shreyD2408/Custom_Esp32_Devboard/BOM.md

# ESP32 Custom DevBoard – bill of materials

<!-- Generated by Half Life from project cmuuqpnhf09n301smdetldqip. Edits here are overwritten on the next sync. -->
<!-- Generated: 2026-10-11T19:33:44.635Z -->

> [!NOTE]
> This parts list is mirrored from [Half Life](https://halflife.hackclub.com). Editing it here will not change the platform's copy, and the next sync overwrites this file.

| Week | Tier | Parts funding |
| --- | --- | --- |
| Week 1 | Tier 2 | $65.00 |

| Part | What it's for | Qty | Unit | Total | Vendor |
| --- | --- | --- | --- | --- | --- |
| [Panasonic Push Button](https://www.lcsc.com/product-detail/C528967.html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) | For user input buttons, and BOOT/RESET buttons | 5 | $0.38 | $1.90 | [LCSC](https://www.lcsc.com/product-detail/C528967.html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) |
| [Ceramic 1uf Capacitors](https://www.lcsc.com/product-detail/C76930.html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) | Passive/Capacitors | 50 | $0.01 | $0.50 | [LCSC](https://www.lcsc.com/product-detail/C76930.html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) |
| [Ceramic 2.2uf Capacitors](https://www.lcsc.com/product-detail/C170151.html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) | Passive/Capacitors | 20 | $0.02 | $0.40 | [LCSC](https://www.lcsc.com/product-detail/C170151.html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) |
| [Ceramic 10uf Capacitors](https://www.lcsc.com/product-detail/C19702.html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) | Passive/Capacitors | 20 | $0.03 | $0.60 | [LCSC](https://www.lcsc.com/product-detail/C19702.html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) |
| [Ceramic 100nf Capacitors](https://www.lcsc.com/product-detail/C14663.html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) | Passive/Capacitors | 50 | $0.01 | $0.50 | [LCSC](https://www.lcsc.com/product-detail/C14663.html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) |
| [Ceramic 10nf Capacitors](https://www.lcsc.com/product-detail/C100042.html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) | Passive/Capacitors | 50 | $0.01 | $0.50 | [LCSC](https://www.lcsc.com/product-detail/C100042.html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) |
| [Ceramic 220nf Capacitors](https://www.lcsc.com/product-detail/C42416726.html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) | Passive/Capacitors | 2 | $0.33 | $0.66 | [LCSC](https://www.lcsc.com/product-detail/C42416726.html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) |
| [USB-C Connector](https://www.lcsc.com/product-detail/C2765186.html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) | Programming and Power Input | 20 | $0.08 | $1.60 | [LCSC](https://www.lcsc.com/product-detail/C2765186.html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) |
| [ESD Protection Diodes](https://www.lcsc.com/product-detail/C2905646.html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) | Protects circuit from power surges | 20 | $0.03 | $0.60 | [LCSC](https://www.lcsc.com/product-detail/C2905646.html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) |
| [Fuse](https://www.lcsc.com/product-detail/C2905646.html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) | Protects circuit from short circuits and over current | 5 | $0.09 | $0.45 | [LCSC](https://www.lcsc.com/product-detail/C2905646.html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) |
| [MAX98357A Audio Amplifier](https://www.lcsc.com/product-detail/C136357.html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) | To amplify audio - sent to input speakers | 1 | $1.33 | $1.33 | [LCSC](https://www.lcsc.com/product-detail/C136357.html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) |
| [DRV8833PW Motor Drivers](https://www.lcsc.com/product-detail/C544801.html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) | To control motors | 2 | $1.65 | $3.30 | [LCSC](https://www.lcsc.com/product-detail/C544801.html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) |
| [LM1117 Voltage Regulator](https://www.lcsc.com/product-detail/C126019.html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) | Linear voltage regular to bring down 5v to 3.3v | 5 | $0.18 | $0.90 | [LCSC](https://www.lcsc.com/product-detail/C126019.html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) |
| [USBLC6-25C6](https://www.lcsc.com/product-detail/C2827654.html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) | Protects circuit from high speed data interferences and voltage spikes | 10 | $0.05 | $0.50 | [LCSC](https://www.lcsc.com/product-detail/C2827654.html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) |
| [10K Resistors](https://www.lcsc.com/product-detail/C98220.html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) | Passive/Resistors | 100 | $0.01 | $1.00 | [LCSC](https://www.lcsc.com/product-detail/C98220.html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) |
| [2.2K Resistors](https://www.lcsc.com/product-detail/C2907005.html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) | Passive/Resistors | 100 | $0.01 | $1.00 | [LCSC](https://www.lcsc.com/product-detail/C2907005.html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) |
| [5.1K Resistors](https://www.lcsc.com/product-detail/C2907044.html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) | Passive/Resistors | 100 | $0.01 | $1.00 | [LCSC](https://www.lcsc.com/product-detail/C2907044.html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) |
| [1M Resistors](https://www.lcsc.com/product-detail/C2907003.html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) | Passive/Resistors | 100 | $0.01 | $1.00 | [LCSC](https://www.lcsc.com/product-detail/C2907003.html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) |
| [1K Resistors](https://www.lcsc.com/product-detail/C2907002.html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) | Passive/Resistors | 100 | $0.01 | $1.00 | [LCSC](https://www.lcsc.com/product-detail/C2907002.html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) |
| [ESP32-S3-MINI-1](https://www.lcsc.com/product-detail/C2913206.html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) | Wi-Fi and the brain of the pcb | 1 | $4.76 | $4.76 | [LCSC](https://www.lcsc.com/product-detail/C2913206.html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) |
| [01x02 Terminal Blocks](https://www.lcsc.com/product-detail/C695629.html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) | Input Power & Motor Connections | 5 | $0.10 | $0.50 | [LCSC](https://www.lcsc.com/product-detail/C695629.html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) |
| [01x03  Terminal Blocks](https://www.lcsc.com/product-detail/C918121.html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) | Output Power Connections | 5 | $0.35 | $1.75 | [LCSC](https://www.lcsc.com/product-detail/C918121.html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) |
| [LED](https://www.lcsc.com/product-detail/C19171390.html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) | Power Indication | 100 | $0.01 | $1.00 | [LCSC](https://www.lcsc.com/product-detail/C19171390.html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) |
| [Custom PCB Board](https://cart.jlcpcb.com/quote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) | Where I put on all the components | 5 | $2.60 | $13.00 | [JLCPCB](https://cart.jlcpcb.com/quote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) |
| **Parts subtotal** | — | — | — | **$39.75** | — |
| **Tax & shipping** | — | — | — | **$17.36** | — |
| **Total** | — | — | — | **$57.11** | — |

$7.89 left of the tier's funding.
