shreyD2408/Custom_Esp32_Devboard/hardware/ESP32 Custom Devboard.kicad_pcb

## KiCad design hardware/ESP32 Custom Devboard.kicad_pcb (2026-10-10)

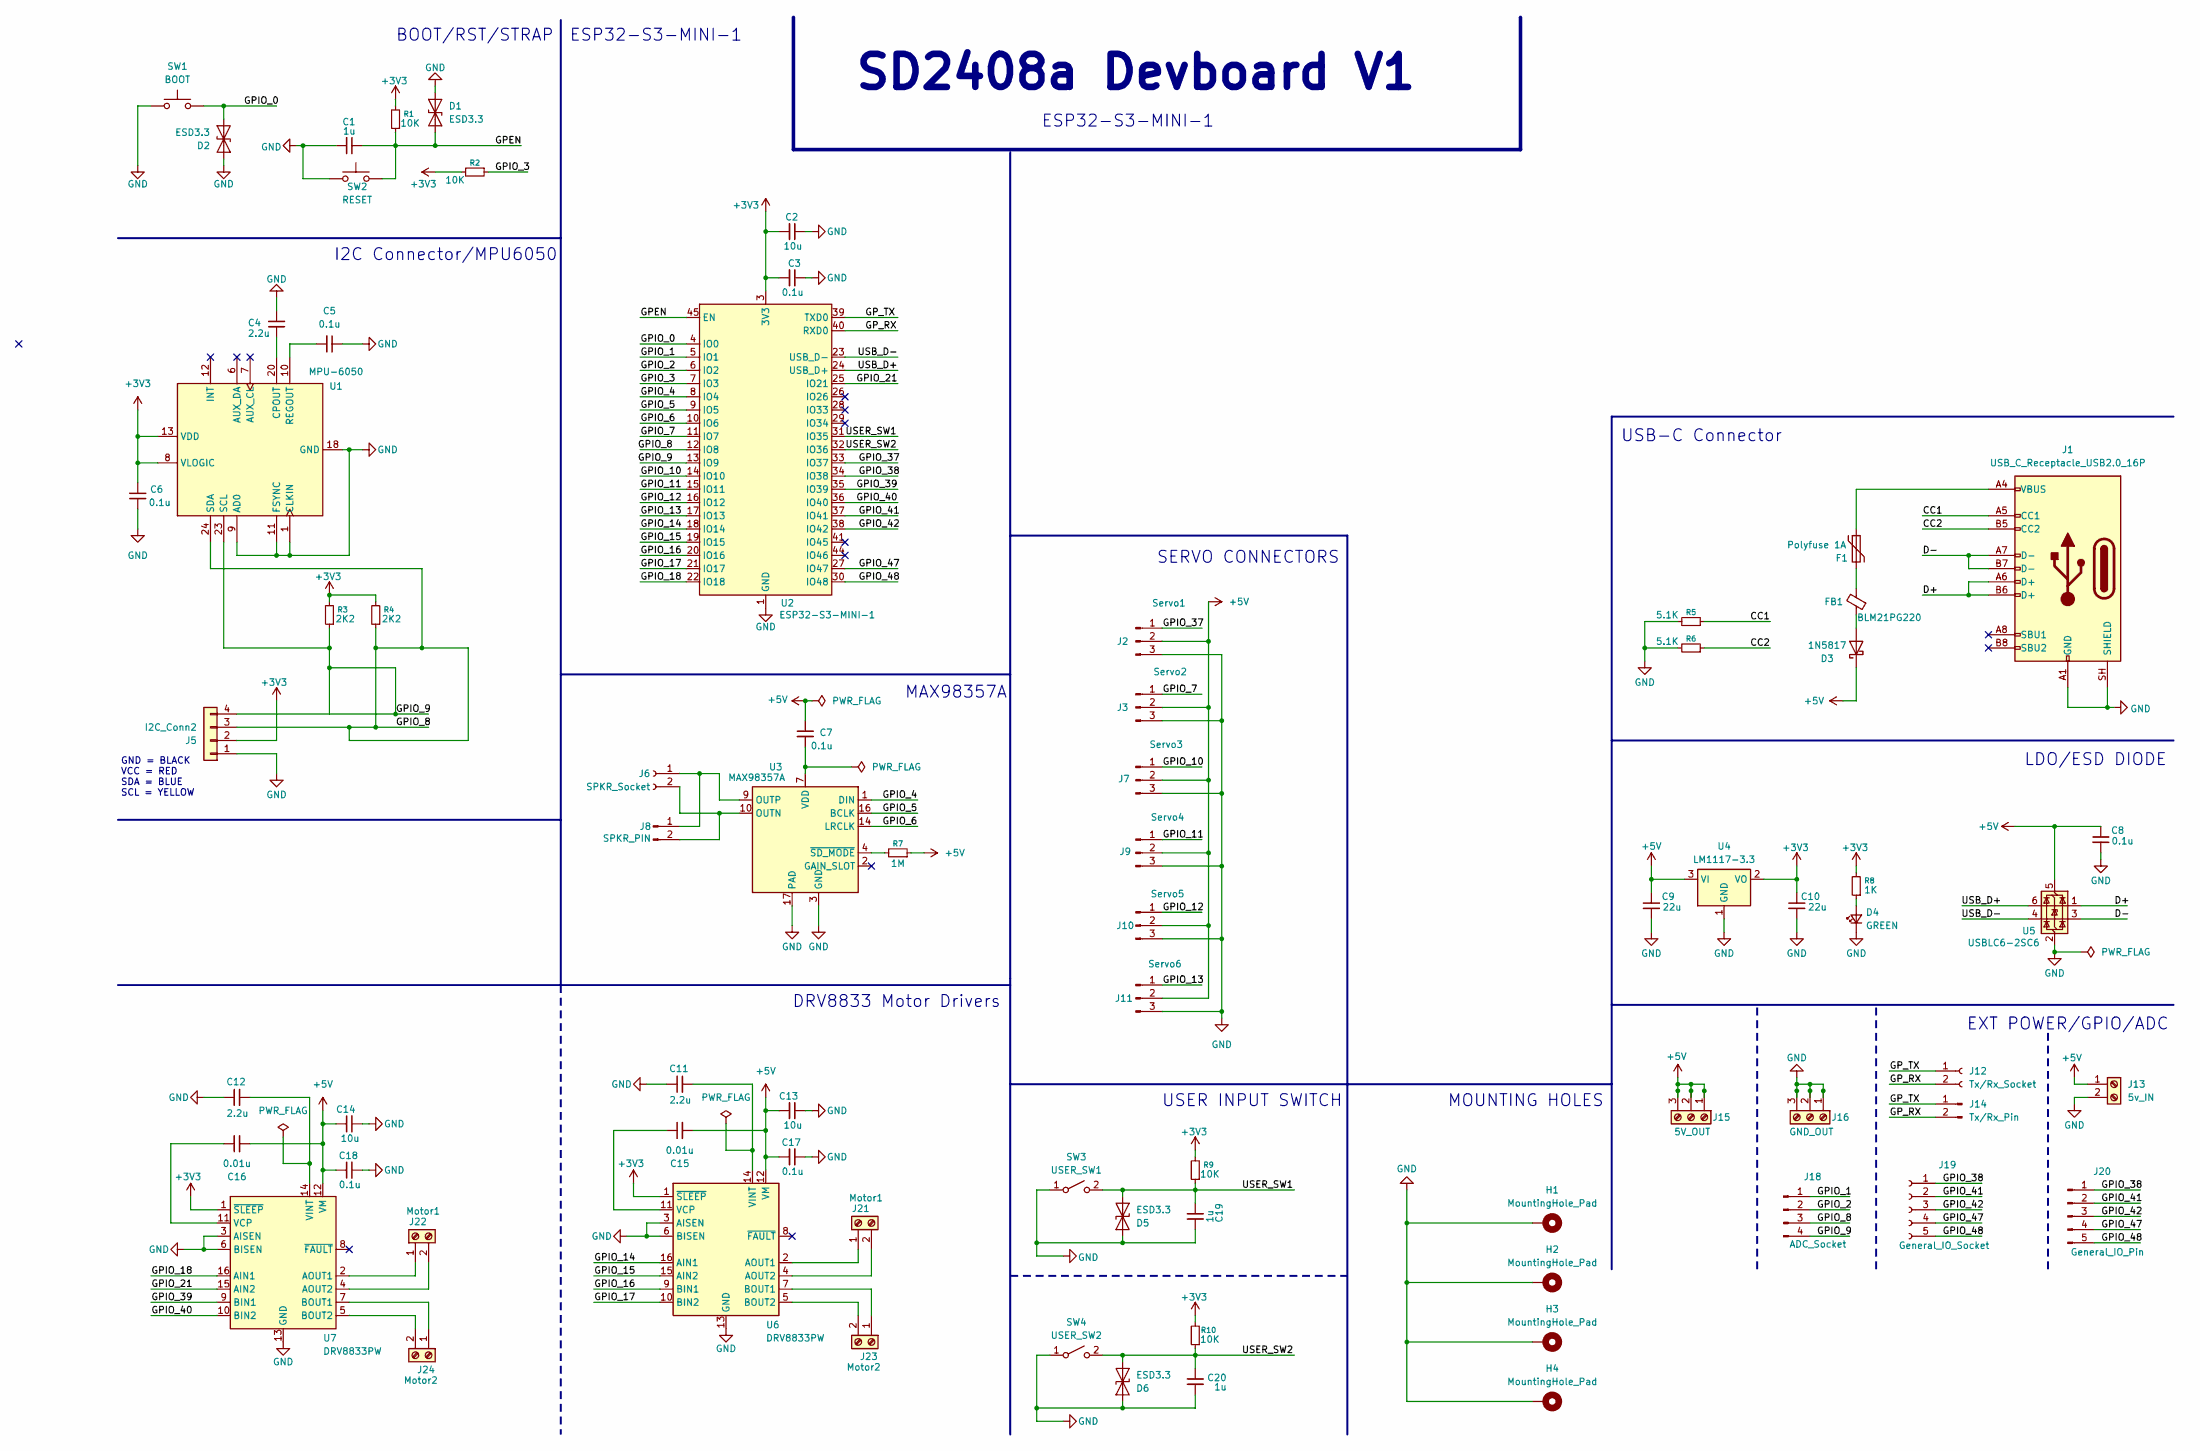
[picture p1: schematic ESP32 Custom Devboard.kicad_sch]

Parts:
C1, C19, C20: 1u; C_0201_0603Metric_Pad0.64x0.40mm_HandSolder
C2, C13, C14: 10u; C_0402_1005Metric_Pad0.74x0.62mm_HandSolder
C3, C5, C6, C7, C8, C17, C18: 0.1u; C_0402_1005Metric_Pad0.74x0.62mm_HandSolder
C4, C11, C12: 2.2u; C_0201_0603Metric_Pad0.64x0.40mm_HandSolder
C9, C10: 22u; C_1825_4564Metric_Pad1.57x6.80mm_HandSolder
C15, C16: 0.01u; C_1206_3216Metric_Pad1.33x1.80mm_HandSolder
D1, D2, D5, D6: ESD3.3; D_SOD-923
D3: 1N5817; D_DO-41_SOD81_P10.16mm_Horizontal
D4: GREEN; LED_0402_1005Metric_Pad0.77x0.64mm_HandSolder
F1: Polyfuse 1A; Fuse_1206_3216Metric
FB1: BLM21PG220; L_0805_2012Metric_Pad1.05x1.20mm_HandSolder
H1, H2, H3, H4: MountingHole_Pad; MountingHole_3.2mm_M3_DIN965_Pad
J1: USB_C_Receptacle_USB2.0_16P; USB_C_Receptacle_HCTL_HC-TYPE-C-16P-01A
J2: Servo1; PinHeader_1x03_P2.54mm_Vertical
J3: Servo2; PinHeader_1x03_P2.54mm_Vertical
J5: I2C_Conn2; PinSocket_1x04_P2.54mm_Vertical
J6: SPKR_Socket; PinSocket_1x02_P2.54mm_Vertical
J7: Servo3; PinHeader_1x03_P2.54mm_Vertical
J8: SPKR_PIN; PinHeader_1x02_P2.54mm_Vertical
J9: Servo4; PinHeader_1x03_P2.54mm_Vertical
J10: Servo5; PinHeader_1x03_P2.54mm_Vertical
J11: Servo6; PinHeader_1x03_P2.54mm_Vertical
J12: Tx/Rx_Socket; PinSocket_1x02_P2.54mm_Vertical
J13: 5v_IN; TerminalBlock_4Ucon_1x02_P3.50mm_Horizontal
J14: Tx/Rx_Pin; PinHeader_1x02_P2.54mm_Vertical
J15: 5V_OUT; TerminalBlock_Xinya_XY308-2.54-3P_1x03_P2.54mm_Horizontal
J16: GND_OUT; TerminalBlock_Xinya_XY308-2.54-3P_1x03_P2.54mm_Horizontal
J18: ADC_Socket; PinSocket_1x04_P2.54mm_Vertical
J19: General_IO_Socket; PinSocket_1x05_P2.54mm_Vertical
J20: General_IO_Pin; PinHeader_1x05_P2.54mm_Vertical
J21, J22: Motor1; TerminalBlock_4Ucon_1x02_P3.50mm_Horizontal
J23, J24: Motor2; TerminalBlock_4Ucon_1x02_P3.50mm_Horizontal
R1, R2, R9, R10: 10K; R_0402_1005Metric_Pad0.72x0.64mm_HandSolder
R3, R4: 2K2; R_0402_1005Metric_Pad0.72x0.64mm_HandSolder
R5, R6: 5.1K; R_0402_1005Metric_Pad0.72x0.64mm_HandSolder
R7: 1M; R_0402_1005Metric_Pad0.72x0.64mm_HandSolder
R8: 1K; R_0402_1005Metric_Pad0.72x0.64mm_HandSolder
SW1: BOOT; DIP-24_W7.62mm
SW2: RESET; DIP-24_W7.62mm
SW3: USER_SW1; SW_SPST_EVQP2_ShortPushTravel_H2.1mm
SW4: USER_SW2; SW_SPST_EVQP2_ShortPushTravel_H2.1mm
U1: MPU-6050; InvenSense_QFN-24_4x4mm_P0.5mm
U2: ESP32-S3-MINI-1; ESP32-S2-MINI-1
U3: MAX98357A; TQFN-16-1EP_3x3mm_P0.5mm_EP1.23x1.23mm
U4: LM1117-3.3; SOT-223-3_TabPin2
U5: USBLC6-2SC6; SOT-23-6
U6, U7: DRV8833PW; TSSOP-16_4.4x5mm_P0.65mm

Connections:
+3V3: C2.2, C3.2, C6.1, C10.1, J5.2, R1.2, R2.2, R3.2, R4.2, R8.2, R9.2, R10.2, U1.8 (VLOGIC), U1.13 (VDD), U2.3 (3V3), U4.2 (VO), U6.1 (~SLEEP), U7.1 (~SLEEP)
+5V: C7.2, C8.1, C9.1, C13.2, C14.2, C15.2, C16.2, C17.2, C18.2, D3.1 (K), J2.2, J3.2, J7.2, J9.2, J10.2, J11.2, J13.1, J15.1, J15.2, J15.3, R7.1, U4.3 (VI), U5.5 (VBUS), U6.12 (VM), U7.12 (VM)
/CC1: J1.A5 (CC1), R5.1
/CC2: J1.B5 (CC2), R6.1
/D+: J1.A6 (D+), J1.B6 (D+), U5.1 (I/O1)
/D-: J1.A7 (D-), J1.B7 (D-), U5.3 (I/O2)
/GPEN: C1.1, D1.1 (A1), R1.1, SW2.2 (B), U2.45 (EN)
/GPIO_0: D2.1 (A1), SW1.2 (B), U2.4 (IO0)
/GPIO_1: J18.1, U2.5 (IO1)
/GPIO_2: J18.2, U2.6 (IO2)
/GPIO_3: R2.1, U2.7 (IO3)
/GPIO_4: U2.8 (IO4), U3.1 (DIN)
/GPIO_5: U2.9 (IO5), U3.16 (BCLK)
/GPIO_6: U2.10 (IO6), U3.14 (LRCLK)
/GPIO_7: J3.1, U2.11 (IO7)
/GPIO_8: J5.3, J18.3, R4.1, U1.24 (SDA), U2.12 (IO8)
/GPIO_9: J5.4, J18.4, R3.1, U1.23 (SCL), U2.13 (IO9)
/GPIO_10: J7.1, U2.14 (IO10)
/GPIO_11: J9.1, U2.15 (IO11)
/GPIO_12: J10.1, U2.16 (IO12)
/GPIO_13: J11.1, U2.17 (IO13)
/GPIO_14: U2.18 (IO14), U6.16 (AIN1)
/GPIO_15: U2.19 (IO15), U6.15 (AIN2)
/GPIO_16: U2.20 (IO16), U6.9 (BIN1)
/GPIO_17: U2.21 (IO17), U6.10 (BIN2)
/GPIO_18: U2.22 (IO18), U7.16 (AIN1)
/GPIO_21: U2.25 (IO21), U7.15 (AIN2)
/GPIO_37: J2.1, U2.33 (IO37)
/GPIO_38: J19.1, J20.1, U2.34 (IO38)
/GPIO_39: U2.35 (IO39), U7.9 (BIN1)
/GPIO_40: U2.36 (IO40), U7.10 (BIN2)
/GPIO_41: J19.2, J20.2, U2.37 (IO41)
/GPIO_42: J19.3, J20.3, U2.38 (IO42)
/GPIO_47: J19.4, J20.4, U2.27 (IO47)
/GPIO_48: J19.5, J20.5, U2.30 (IO48)
/GP_RX: J12.2, J14.2, U2.40 (RXD0)
/GP_TX: J12.1, J14.1, U2.39 (TXD0)
/USB_D+: U2.24 (USB_D+), U5.6 (I/O1)
/USB_D-: U2.23 (USB_D-), U5.4 (I/O2)
/USER_SW1: C19.2, D5.1 (A1), R9.1, SW3.2 (B), U2.31 (IO35)
/USER_SW2: C20.2, D6.1 (A1), R10.1, SW4.2 (B), U2.32 (IO36)
GND: C1.2, C2.1, C3.1, C4.1, C5.2, C6.2, C8.2, C9.2, C10.2, C11.2, C12.2, C13.1, C14.1, C17.1, C18.1, C19.1, C20.1, D1.2 (A2), D2.2 (A2), D4.1 (K), D5.2 (A2), D6.2 (A2), H1.1 (1_1), H2.1 (1_1), H3.1 (1_1), H4.1 (1_1), J1.A1 (GND), J1.A12 (GND), J1.B1 (GND), J1.B12 (GND), J1.SH (SHIELD), J2.3, J3.3, J5.1, J7.3, J9.3, J10.3, J11.3, J13.2, J16.1, J16.2, J16.3, R5.2, R6.2, SW1.1 (A), SW2.1 (A), SW3.1 (A), SW4.1 (A), U1.1 (CLKIN), U1.9 (AD0), U1.11 (FSYNC), U1.18 (GND), U2.1 (GND), U2.2 (GND), U2.42 (GND), U2.43 (GND), U2.46 (GND), U2.47 (GND), U2.48 (GND), U2.49 (GND), U2.50 (GND), U2.51 (GND), U2.52 (GND), U2.53 (GND), U2.54 (GND), U2.55 (GND), U2.56 (GND), U2.57 (GND), U2.58 (GND), U2.59 (GND), U2.60 (GND), U2.61 (GND), U2.62 (GND), U2.63 (GND), U2.64 (GND), U2.65 (GND), U3.3 (GND), U3.11 (GND), U3.15 (GND), U3.17 (PAD), U4.1 (GND), U5.2 (GND), U6.3 (AISEN), U6.6 (BISEN), U6.13 (GND), U7.3 (AISEN), U7.6 (BISEN), U7.13 (GND)
unnamed: C7.1, U3.7 (VDD), U3.8 (VDD)
unnamed: D3.2 (A), FB1.1
unnamed: D4.2 (A), R8.1
unnamed: F1.1, J1.A4 (VBUS), J1.A9 (VBUS), J1.B4 (VBUS), J1.B9 (VBUS)
unnamed: F1.2, FB1.2
unnamed: J6.1, J8.1, U3.9 (OUTP)
unnamed: J6.2, J8.2, U3.10 (OUTN)
unnamed: J21.1, U6.2 (AOUT1)
unnamed: J21.2, U6.4 (AOUT2)
unnamed: J22.1, U7.2 (AOUT1)
unnamed: J22.2, U7.4 (AOUT2)
unnamed: J23.1, U6.7 (BOUT1)
unnamed: J23.2, U6.5 (BOUT2)
unnamed: J24.1, U7.7 (BOUT1)
unnamed: J24.2, U7.5 (BOUT2)
unnamed: C4.2, U1.20 (CPOUT)
unnamed: C5.1, U1.10 (REGOUT)
unnamed: R7.2, U3.4 (~SD_MODE)
unnamed: C15.1, U6.11 (VCP)
unnamed: C11.1, U6.14 (VINT)
unnamed: C16.1, U7.11 (VCP)
unnamed: C12.1, U7.14 (VINT)

Notes on the sheet:
DRV8833 Motor Drivers
MOUNTING HOLES
ESP32-S3-MINI-1
I2C Connector/MPU6050
SD2408a Devboard V1
ESP32-S3-MINI-1
MAX98357A
LDO/ESD DIODE
GND = BLACK VCC = RED SDA = BLUE SCL = YELLOW
EXT POWER/GPIO/ADC
BOOT/RST/STRAP
USER INPUT SWITCH
USB-C Connector
SERVO CONNECTORS

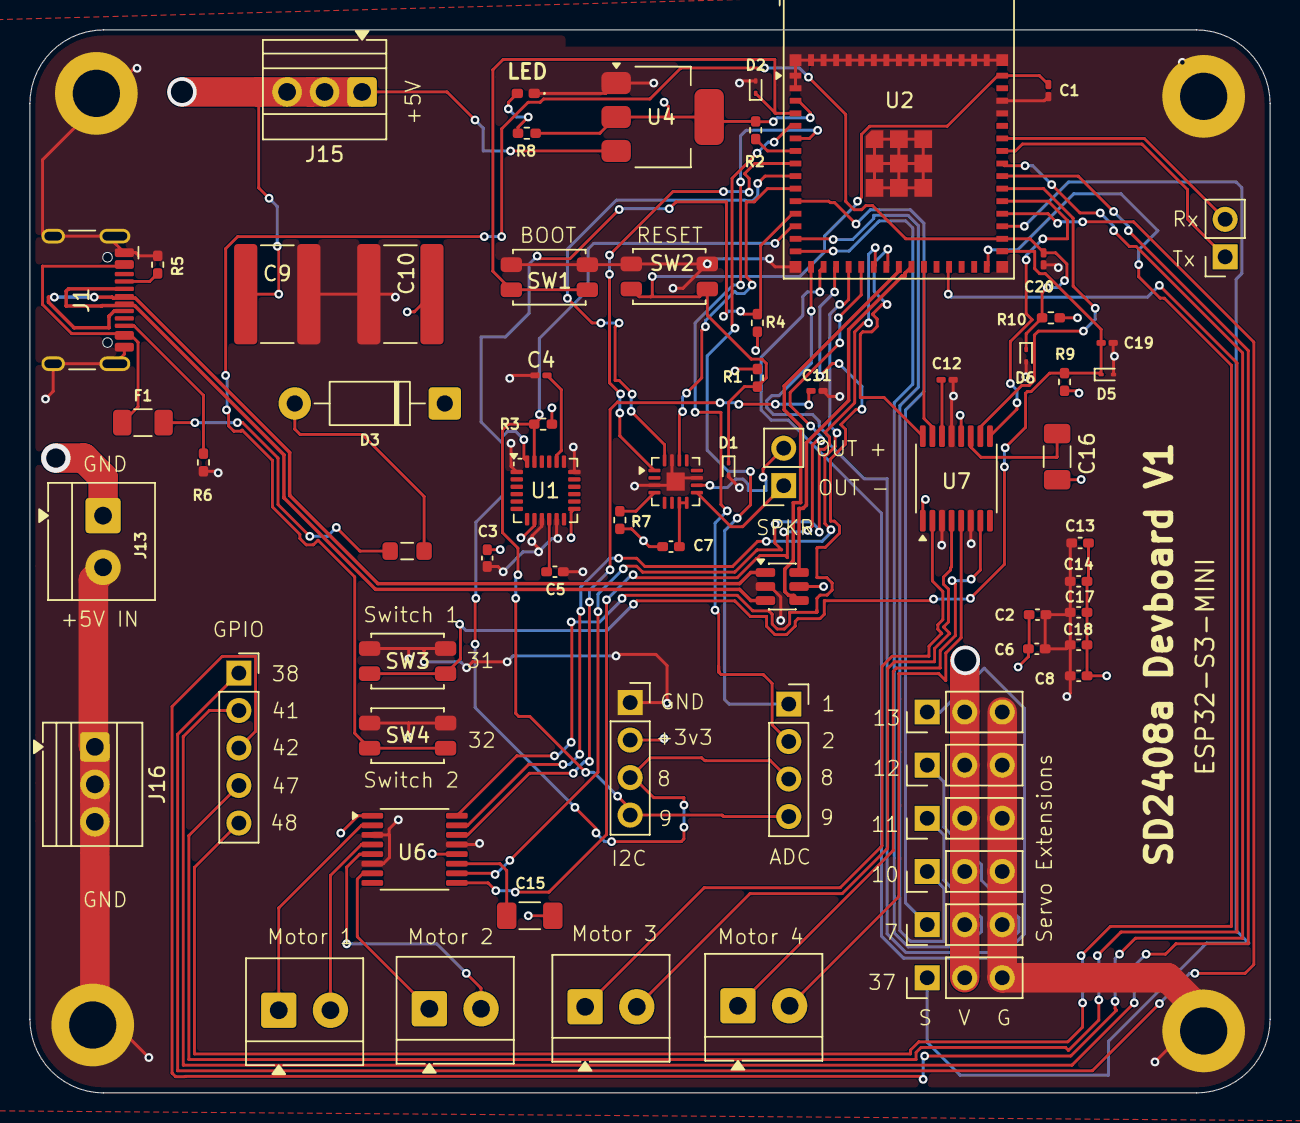
[picture p2: board ESP32 Custom Devboard.kicad_pcb from above]

Board: 4 copper layers, 84.0 x 72.0 mm, 72 parts (0 on the bottom side), 64 nets.
