shreyD2408/Custom_Esp32_Devboard/JOURNAL.md

# ESP32 Custom DevBoard – devlog

<!-- Generated by Half Life from project cmuuqpnhf09n301smdetldqip. Edits here are overwritten on the next sync. -->
<!-- Generated: 2026-10-11T22:48:00.308Z -->

> [!NOTE]
> This devlog is mirrored from [Half Life](https://halflife.hackclub.com). Editing it here will not change the platform's copy, and the next sync overwrites this file.

> A custom ESP32-S3 Dev Board with built in motor drivers and servo plug-in slots. Also features a built in speaker and an amplifier as a bonus feature.

| Week | Tier | Hours logged | Entries |
| --- | --- | --- | --- |
| Week 1 | Tier 2 | 39.3h | 11 |

## Contents

1. [2026-10-05 – Work session](#2026-10-05-work-session)
2. [2026-10-05 – Work session](#2026-10-05-work-session)
3. [2026-10-06 – Work session](#2026-10-06-work-session)
4. [2026-10-06 – Work session](#2026-10-06-work-session)
5. [2026-10-07 – Work session](#2026-10-07-work-session)
6. [2026-10-07 – Work session](#2026-10-07-work-session)
7. [2026-10-08 – Work session](#2026-10-08-work-session)
8. [2026-10-08 – Work session](#2026-10-08-work-session)
9. [2026-10-10 – Work session](#2026-10-10-work-session)
10. [2026-10-10 – Work session](#2026-10-10-work-session)
11. [2026-10-11 – Work session](#2026-10-11-work-session)

## Design

### 2026-10-05 – Work session

**3h**

[Timelapse](https://lookout.hackclub.com/api/media/d403ffa5-f4cb-4e85-83e8-78e31759b2da/video.mp4)

### 2026-10-05 – Work session

**1.75h**

[Timelapse](https://lookout.hackclub.com/api/media/4986f86d-3dc5-4043-98b6-3ae43ccbdc0a/video.mp4)

### 2026-10-06 – Work session

**0.42h**

[Timelapse](https://lookout.hackclub.com/api/media/19cef9ec-cf5d-4126-b7f5-b60a60534b0d/video.mp4)

### 2026-10-06 – Work session

**3.55h**

[Timelapse](https://lookout.hackclub.com/api/media/63f1f090-f7bb-4b49-b928-fb36329a636f/video.mp4)

### 2026-10-07 – Work session

**2.4h**

[Timelapse](https://lookout.hackclub.com/api/media/a4bdbb69-41f1-47bc-bce0-3c65cf175c5b/video.mp4)

### 2026-10-07 – Work session

**4.73h**

[Timelapse](https://lookout.hackclub.com/api/media/f04b0470-165d-4922-b6a3-af4892e090eb/video.mp4)

### 2026-10-08 – Work session

**3.18h**

[Timelapse](https://lookout.hackclub.com/api/media/a51cf76d-4895-4dc6-b90a-00982fdbf257/video.mp4)

### 2026-10-08 – Work session

**5.3h**

[Timelapse](https://lookout.hackclub.com/api/media/0fae387b-4191-4a5d-aada-0a6168162c84/video.mp4)

### 2026-10-10 – Work session

**6.47h**

[Timelapse](https://lookout.hackclub.com/api/media/0eca0ce2-35a8-4183-bcf8-0468e920dea0/video.mp4)

### 2026-10-10 – Work session

**6.68h**

[Timelapse](https://lookout.hackclub.com/api/media/b7372355-9751-4a53-883c-622872df1184/video.mp4)

### 2026-10-11 – Work session

**1.82h**

[Timelapse](https://lookout.hackclub.com/api/media/6e1f4e00-68d2-4be2-90f0-fbbef3c36c2c/video.mp4)
