shreyD2408/Custom_Esp32_Devboard/(commit log)

2026-10-05 Sync ESP32 Custom DevBoard from Half Life
2026-10-11 Update README with project description
    Added a project description for the custom ESP32 development board.
2026-10-11 Enhance README with component descriptions and schematic
    Added detailed explanation of components and schematic.
2026-10-11 Update README with PCB Layout and 3D Model sections
    Added sections for PCB Layout and 3D Model with images.
2026-10-11 Update PCB layout image in README
    Replaced PCB layout image with a new one.
2026-10-11 Add Bill of Materials section to README
    Added a Bill of Materials (BOM) section with details on parts, quantities, costs, and vendors.
2026-10-11 Revise BOM section and add cost summary
    Updated the Bill of Materials section with improved terminology and formatting. Added a Cost Summary table for clarity.
2026-10-11 Update grand total currency from CAD to USD
2026-10-11 Add link reference to BOM.md in README
    Added a note about links available in BOM.md.
2026-10-16 Revise README with project details and usage instructions
    Updated the README to provide a detailed overview of the ESP32-S3 development board, including its features, purpose, and usage instructions.
